elfren/ER_DrillFrame_AXA/README.md

Ornamental turning 3D printed drill frame using ER collet extensions.
