elfren/ER_DrillFrame_AXA/Spacer_12mm.step

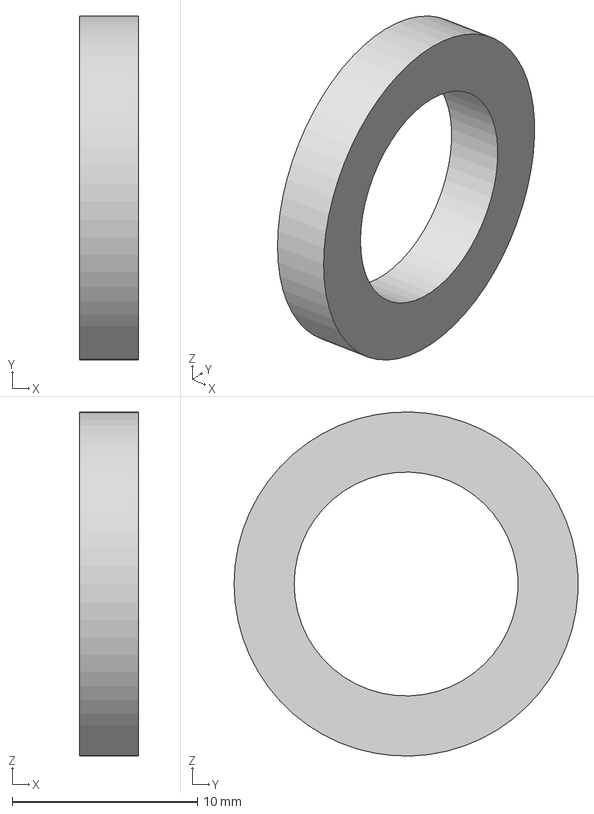
[picture p1: CAD file, 2026-05-19]
Spacer_12mm.step
3.17 x 18.6 x 18.6 mm
