elfren/ER_DrillFrame_AXA/Spacer_20mm.step

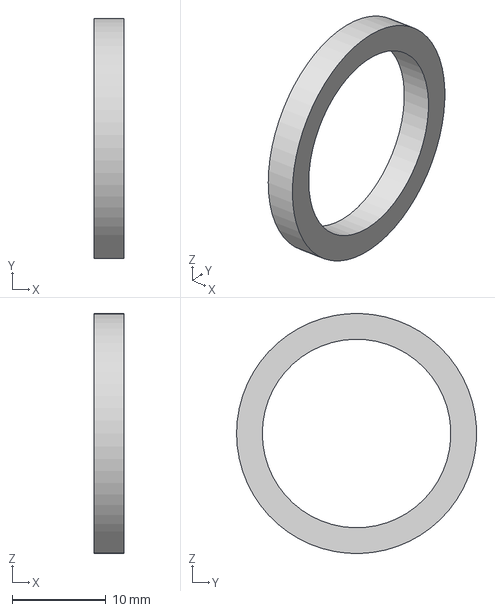
[picture p2: CAD file, 2026-05-19]
Spacer_20mm.step
3.17 x 25.6 x 25.6 mm
