elfren/ER_DrillFrame_AXA/Spacer_25mm.step

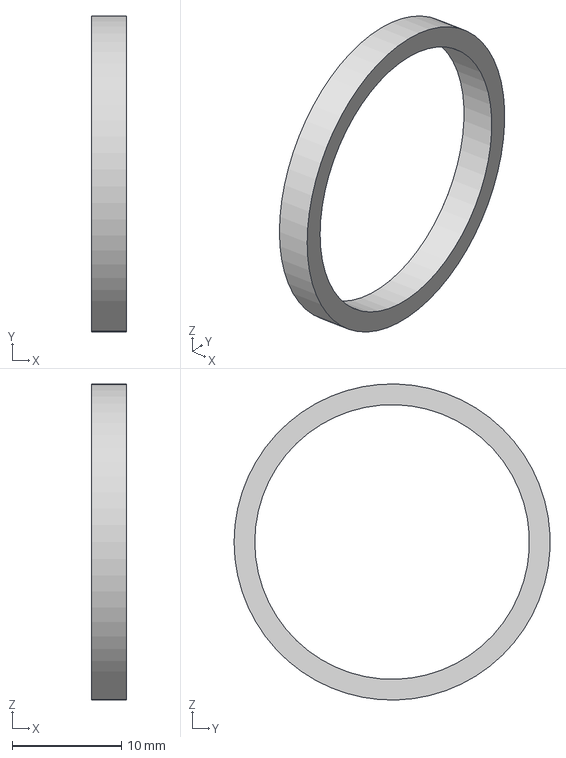
[picture p3: CAD file, 2026-05-19]
Spacer_25mm.step
3.17 x 28.9 x 28.9 mm
