elfren/ER_DrillFrame_AXA/Pulley_12mm_Bore.step

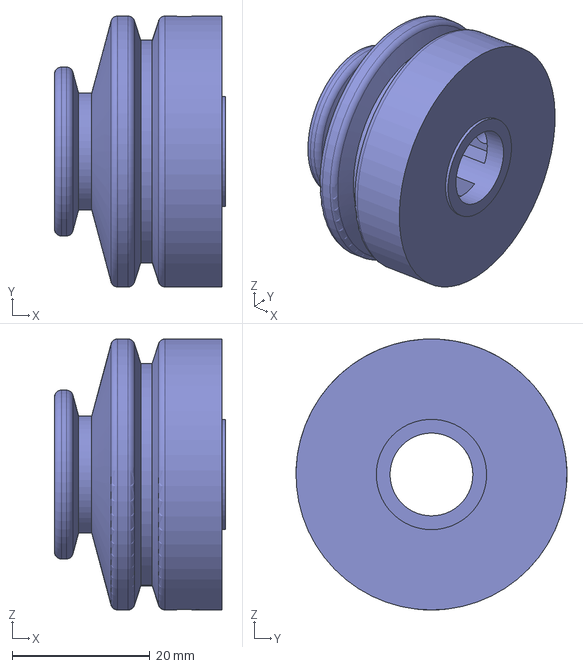
[picture p4: CAD file, 2026-05-19]
Pulley_12mm_Bore.step
24.8 x 39.3 x 39.3 mm
