elfren/ER_DrillFrame_AXA/DrillFrame_AXA.step

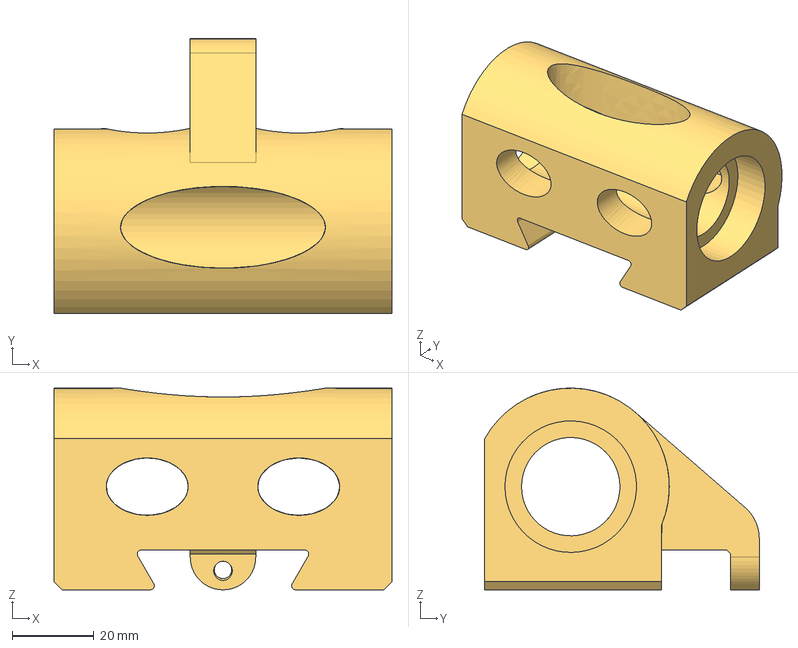
[picture p5: CAD file, 2026-05-19]
DrillFrame_AXA.step
82.5 x 67.0 x 49.2 mm
