elfren/ER_DrillFrame_AXA/Pulley_25mm_Bore.step

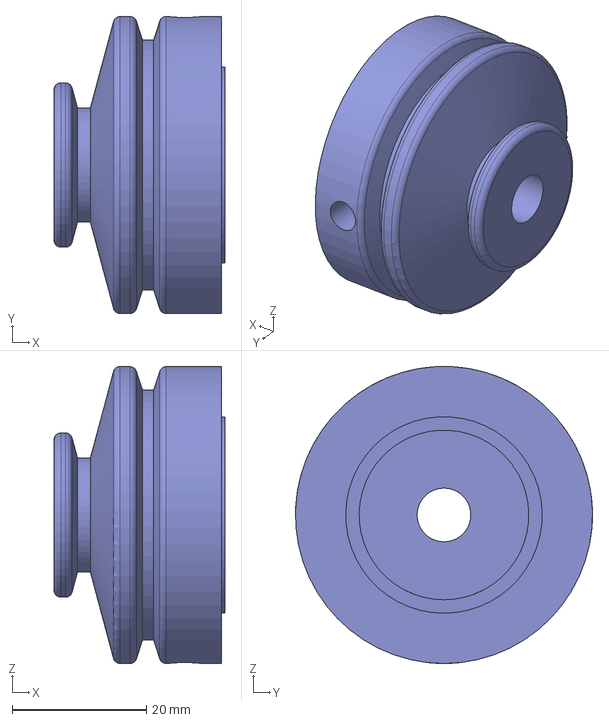
[picture p6: CAD file, 2026-05-19]
Pulley_25mm_Bore.step
25.5 x 44.3 x 44.3 mm
