elfren/ER_DrillFrame_AXA/Pulley_20mm_Bore.step

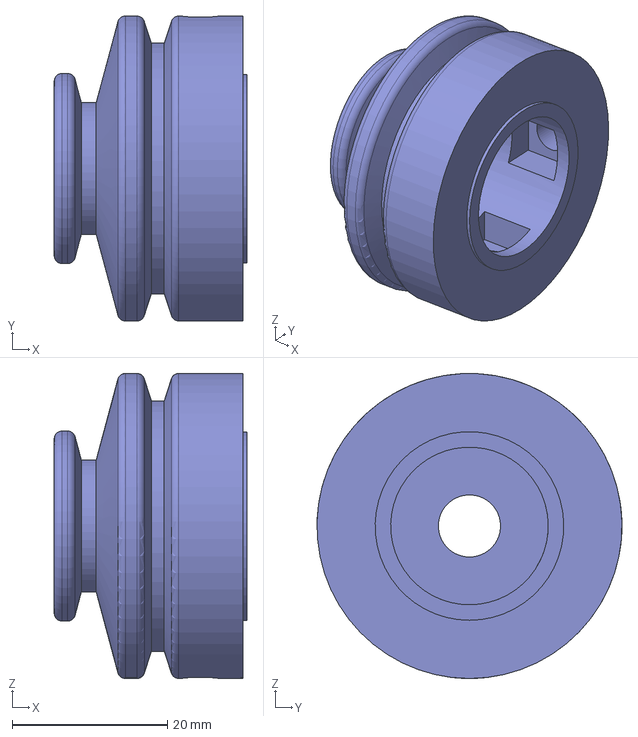
[picture p7: CAD file, 2026-05-19]
Pulley_20mm_Bore.step
24.8 x 39.3 x 39.3 mm
